UNIT-Electronics-MX/unit_devlab_i2c_mpu6050_6_axis_imu/hardware/README.md

# DevLab I2C MPU6050 6-Axis IMU Hardware

## Hardware Scope

This page documents **DevLab I2C MPU6050 6-Axis IMU** using the V1.0 schematic, board views, and available mechanical drawings. Sensor datasheet ratings are not independently validated module limits.

| Field | Value |
|---|---|
| MPN | UE0129 |

## Power Tree

The schematic identifies `U2` as an AP2112K fixed 3.3 V regulator for the MPU-6050 circuit. A separate board-level power-tree drawing is not available; use the [electrical schematic](unit_sch_v_1_0_0_ue129_mpu6050_imu.pdf) for the confirmed connections.

## Block Diagram

UE0129 functional block diagram

## Naming Rules

- Product name: **DevLab I2C MPU6050 6-Axis IMU**.
- Product family: **UNIT DevLab ecosystem**.
- Existing source files retain their published names and revisions.
- Generated Product Reference: `unit_product_reference_v_0_2_0_i2c_mpu6050_6_axis_imu.pdf`.

## Hardware

<div align="center">
<a href="./unit_sch_v_1_0_0_ue129_mpu6050_imu.pdf">V1.0 electrical schematic<br/>Schematic (PDF)</a>
</div>

UE0129 MPU6050 top view

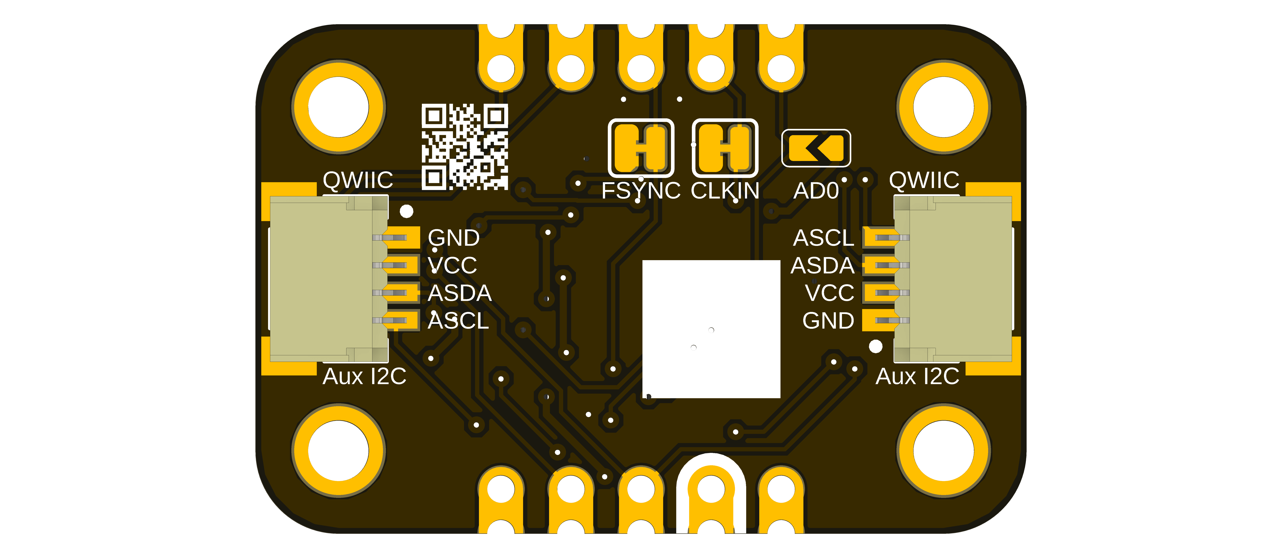
[picture p2: hardware/resources/unit_btm_v_1_1_0_ue0129_mpu6050_3d.png]
UE0129 MPU6050 bottom view


## Pinout

<div align="center">
    <a href="./unit_pinout_v_1_0_0_ue0129_mpu6050_en.pdf"><br/>Pinout</a>
    <br/>
    <br/>
    <br/>

</div>

| Connection group | Signal | Direction / type | Function |
|---|---|---|---|
| `J2` | `VCC` | Power input | Module input rail; allowed range pending validation |
| `J2` | `GND` | Power | Common ground |
| `J2` | `SCL` | I2C clock | Main host-side I2C clock |
| `J2` | `SDA` | I2C data | Main host-side I2C data |
| `J2` | `INT` | Output | MPU-6050 interrupt output |
| `J5` | `AD0` | Input | MPU-6050 I2C address-selection input |
| `J5` | `CLKIN` | Input | External clock input to the MPU-6050 |
| `J5` | `FSYNC` | Input | Frame-synchronization input |
| `J5` | `ASCL` | I2C clock | Host-side connection to the auxiliary I2C clock |
| `J5` | `ASDA` | I2C data | Host-side connection to the auxiliary I2C data |

## Dimensions

<div align="center">
<a href="./resources/unit_dimensions_v_1_0_0_ue0129_mpu6050.png"><br/> Dimensions</a>
</div>

The drawing labels a 27.94 × 18.46 mm board outline, four Ø2.2 mm mounting
holes, and 21.94 × 12.46 mm hole-center spacing. Mechanical tolerances and
physical fit remain pending validation.

## Topology

<div align="center">
<a href="./resources/unit_topology_v_1_0_0_ue0129_mpu6050.png"><br/> Topology</a>
</div>

The schematic confirms the following functional blocks:

| Ref. | Description |
|---|---|
| `IC1` | MPU-6050 three-axis accelerometer and three-axis gyroscope |
| `U2` | AP2112K-3.3 fixed 3.3 V regulator |
| `Q1`, `Q2` | BSS138AKDW dual N-channel MOSFET arrays used for I2C level shifting |
| `J1`, `J3` | Four-position main I2C connectors (`VCC`, `GND`, `SDA`, `SCL`) |
| `J4`, `J6` | Four-position auxiliary I2C connectors (`VCC`, `GND`, `ASDA`, `ASCL`) |
| `J2`, `J5` | 1x5, 2.54 mm signal headers / castellated connections |
| `D1`, `R5` | Red power indicator and 4.7 kΩ series resistor |

## Pin & Connector Layout

| Connector | Signals shown by schematic | Notes |
|---|---|---|
| `J1`, `J3` | `VCC`, `GND`, `SDA`, `SCL` | Main I2C bus; 4-position JST SR-series parts in the BOM |
| `J4`, `J6` | `VCC`, `GND`, `ASDA`, `ASCL` | Auxiliary I2C bus; 4-position JST SR-series parts in the BOM |
| `J2` | `VCC`, `GND`, `SCL`, `SDA`, `INT` | Main interface edge |
| `J5` | `AD0`, `CLKIN`, `FSYNC`, `ASCL`, `ASDA` | Configuration and auxiliary interface edge |

The board artwork labels the four JST connectors as `QWIIC`, but cable and
ecosystem compatibility have not been validated. The BOM lists one four-pin,
1 mm-pitch harness as `Wire`; package contents remain pending confirmation.

## Functional Description

`U2` generates the 3.3 V rail used by the MPU-6050. `Q1` translates the main
`SCL` and `SDA` lines between the `VCC` and 3.3 V domains; `Q2` performs the
same function for `ASCL` and `ASDA`. The MPU-6050 exposes acceleration and
angular-rate data through its main I2C interface. Its interrupt, address
selection, frame-synchronization, external-clock, and auxiliary I2C signals
are routed to board connections.

The schematic shows a 10 kΩ resistor (`R6`) from `AD0` to ground and board
artwork shows solder options for `AD0`, `FSYNC`, and `CLKIN`. The physical
defaults and intended solder-option operation are pending validation.

The BOM also confirms 1 µF regulator capacitors (`C1`, `C2`), a 2.2 nF
capacitor (`C3`), a 100 nF capacitor (`C4`), 10 nF capacitors (`C5`, `C6`),
nine 10 kΩ resistors, and the red indicator LED. Component ratings are not
module-level electrical ratings.

The MPU-6050 product specification documents selectable accelerometer ranges
of ±2 g, ±4 g, ±8 g, and ±16 g; selectable gyroscope ranges of ±250,
±500, ±1000, and ±2000 dps; and 16-bit conversion for each axis. It also
specifies a maximum 400 kHz I2C clock for the sensor. These are sensor
characteristics, not independently validated limits for the complete module.

## Applications

- Evaluation of three-axis acceleration and three-axis angular rate
- Motion-sensing prototypes
- I2C sensor integration and educational experiments
- Experiments with interrupt, synchronization, and auxiliary-sensor signals

## References

- [Repository](https://github.com/UNIT-Electronics-MX/unit_devlab_i2c_mpu6050_6_axis_imu)
- [MPU-6000 and MPU-6050 Product Specification, Revision 3.4](https://github.com/UNIT-Electronics-MX/unit_devlab_i2c_mpu6050_6_axis_imu/blob/main/hardware/resources/external/mpu-6050_datasheet_v3%204.pdf)
- [Schematic Diagram](https://github.com/UNIT-Electronics-MX/unit_devlab_i2c_mpu6050_6_axis_imu/blob/main/hardware/unit_sch_v_1_0_0_ue129_mpu6050_imu.pdf)
- [Manufacturing BOM](https://github.com/UNIT-Electronics-MX/unit_devlab_i2c_mpu6050_6_axis_imu/blob/main/hardware/resources/UNIT-0129-%20MPU6050-20260803T164655Z-1-001/UNIT-0129-%20MPU60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)
- [Experimental DevLab_MPU6050 example](https://github.com/UNIT-Electronics-MX/unit_devlab_i2c_mpu6050_6_axis_imu/blob/main/software/examples/arduino/devlab_mpu6050_basic/devlab_mpu6050_basic.ino)

The sensor datasheet values above apply to the MPU-6050 component. The
module-level electrical limits remain pending board validation.

- [Product Reference](../docs/hardware/unit_product_reference_v_0_2_0_i2c_mpu6050_6_axis_imu.pdf)
