UNIT-Electronics-MX/unit_devlab_i2c_mpu6050_6_axis_imu/tools/product-reference/chapters/06-mechanical.md

## **6 Mechanical Information**

### **6.1 Top View** {.section-page}

UE0129 MPU6050 top view.

### **6.2 Bottom View** {.section-page}

UE0129 MPU6050 bottom view.

### **6.3 Board Dimensions** {.section-page}

Released board dimensions drawing.

The released drawing labels a 27.94 × 18.46 mm board outline, four Ø2.2 mm
mounting holes, and 21.94 × 12.46 mm hole-center spacing. The drawing also
shows ten castellated edge connections. These are drawing values; mechanical
tolerances and fit remain **pending validation**. Use the labeled dimensions
rather than scaling the image.
