UNIT-Electronics-MX/unit_devlab_i2c_mpu6050_6_axis_imu/tools/product-reference/chapters/08-references.md

## **8 Reference Documentation**

| Reference | Location |
|---|---|
| Repository | [UNIT-Electronics-MX/unit_devlab_i2c_mpu6050_6_axis_imu](https://github.com/UNIT-Electronics-MX/unit_devlab_i2c_mpu6050_6_axis_imu) |
| Hardware notes | [Hardware README](https://github.com/UNIT-Electronics-MX/unit_devlab_i2c_mpu6050_6_axis_imu/blob/main/hardware/README.md) |
| Sensor datasheet | [MPU-6000 and MPU-6050 Product Specification, Revision 3.4](https://github.com/UNIT-Electronics-MX/unit_devlab_i2c_mpu6050_6_axis_imu/blob/main/hardware/resources/external/mpu-6050_datasheet_v3%204.pdf) |
| Module schematic | [V1.0 schematic](https://github.com/UNIT-Electronics-MX/unit_devlab_i2c_mpu6050_6_axis_imu/blob/main/hardware/unit_sch_v_1_0_0_ue129_mpu6050_imu.pdf) |
| Schematic image | [V1.0 schematic PNG](https://github.com/UNIT-Electronics-MX/unit_devlab_i2c_mpu6050_6_axis_imu/blob/main/hardware/resources/unit_sch_v_1_0_0_ue129_mpu6050_imu.png) |
| Pinout | [English PDF](https://github.com/UNIT-Electronics-MX/unit_devlab_i2c_mpu6050_6_axis_imu/blob/main/hardware/unit_pinout_v_1_0_0_ue0129_mpu6050_en.pdf) · [Spanish PDF](https://github.com/UNIT-Electronics-MX/unit_devlab_i2c_mpu6050_6_axis_imu/blob/main/hardware/unit_pinout_v_1_0_0_ue0129_mpu6050_es.pdf) |
| Pinout images | [English PNG](https://github.com/UNIT-Electronics-MX/unit_devlab_i2c_mpu6050_6_axis_imu/blob/main/hardware/resources/unit_pinout_v_1_0_0_ue0129_mpu6050_en.png) · [Spanish PNG](https://github.com/UNIT-Electronics-MX/unit_devlab_i2c_mpu6050_6_axis_imu/blob/main/hardware/resources/unit_pinout_v_1_0_0_ue0129_mpu6050_es.png) |
| Board topology | [Top and bottom topology drawing](https://github.com/UNIT-Electronics-MX/unit_devlab_i2c_mpu6050_6_axis_imu/blob/main/hardware/resources/unit_topology_v_1_0_0_ue0129_mpu6050.png) |
| Board dimensions | [Dimensioned drawing](https://github.com/UNIT-Electronics-MX/unit_devlab_i2c_mpu6050_6_axis_imu/blob/main/hardware/resources/unit_dimensions_v_1_0_0_ue0129_mpu6050.png) |
| Manufacturing BOM | [V1.0 BOM](https://github.com/UNIT-Electronics-MX/unit_devlab_i2c_mpu6050_6_axis_imu/blob/main/hardware/resources/UNIT-0129-%20MPU6050-20260803T164655Z-1-001/UNIT-0129-%20MPU60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) |
| Experimental firmware | [DevLab_MPU6050 basic readout](https://github.com/UNIT-Electronics-MX/unit_devlab_i2c_mpu6050_6_axis_imu/blob/main/software/examples/arduino/devlab_mpu6050_basic/devlab_mpu6050_basic.ino) |
| Top view | [3D board view](https://github.com/UNIT-Electronics-MX/unit_devlab_i2c_mpu6050_6_axis_imu/blob/main/hardware/resources/unit_top_v_1_0_0_ue0129_mpu6050_3d.png) |
| Bottom view | [3D board view](https://github.com/UNIT-Electronics-MX/unit_devlab_i2c_mpu6050_6_axis_imu/blob/main/hardware/resources/unit_btm_v_1_1_0_ue0129_mpu6050_3d.png) |
| CAD model | [STEP](https://github.com/UNIT-Electronics-MX/unit_devlab_i2c_mpu6050_6_axis_imu/blob/main/hardware/mechanics/unit_3d_v_1_0_0_ue0129_mpu6050.step) |

Sensor values in this reference are taken from the MPU-6050 portions of the
Revision 3.4 product specification. Module-level limits require separate board
validation.
