UNIT-Electronics-MX/unit_devlab_i2c_mpu6050_6_axis_imu/tools/product-reference/chapters/01-board.md

## **1 The Module**

### **1.1 Board Identification**

| Item | Value |
|---|---|
| Product | DevLab: I2C MPU-6050 6-Axis IMU Module |
| Manufacturer part number | UE0129 |
| Hardware revision | V1.0 |
| Inertial sensor | MPU-6050 |
| Host interface | I2C |
| Product-reference revision | 0.2.0 |

### **1.2 Package Contents**

The BOM includes one four-pin, 1 mm-pitch harness. Package contents and cable
compatibility have not been formally validated; confirm them with the
distributor before purchase or integration.
