UNIT-Electronics-MX/unit_devlab_i2c_mpu6050_6_axis_imu/tools/product-reference/chapters/09-appendix.md

## **9 Appendix**

### **9.1 Source Hierarchy**

This product reference uses the MPU-6000 and MPU-6050 Product Specification,
Revision 3.4 for sensor characteristics, the released schematic for circuit
connectivity, the manufacturing BOM for fitted component identities and
values, and the released pinout, topology, board views, and dimensioned
drawing for visible labels and physical features. A future approved
validation report takes precedence if it conflicts with this edition.

### **9.2 Items Pending Validation**

- Module `VCC` operating and absolute-maximum ratings
- Module current consumption and host-side logic levels
- Module-level I2C clock testing, board-default address, and configuration sequences
- Mechanical tolerances and physical fit against the dimensioned drawing
- Solder-option defaults and connector orientation
- Cable and ecosystem compatibility
- Validated firmware examples and measurement results

### **9.3 Document Control**

| Field | Value |
|---|---|
| Product | DevLab: I2C MPU-6050 6-Axis IMU Module |
| Manufacturer part number | UE0129 |
| Hardware revision | V1.0 |
| Product-reference revision | 0.2.0 |
| Publication date | 2026-10-21 |
| Firmware status | Experimental; not validated by this edition |
