UNIT-Electronics-MX/unit_devlab_i2c_mpu6050_6_axis_imu/docs/hardware/index.html

UNIT Electronics · DevLab

# DevLab I2C MPU-6050 6-Axis IMU Module

Direct links to hardware documentation and product files for use in external platforms.

24 files 14 images 9 formats 63.2 MB total

Search hardware resources

## Product documents

4 files

DOCX 7.6 MB

### Product Reference

Editable product reference

unit_product_reference_v_0_2_0_i2c_mpu6050_6_axis_imu.docx

Copy link Open file

PDF 8.6 MB

### Product Reference

Publication-ready product reference

unit_product_reference_v_0_2_0_i2c_mpu6050_6_axis_imu.pdf

Copy link Open file

PDF 53.9 KB

### Schematic

Electrical schematic

unit_sch_v_1_0_0_ue129_mpu6050_imu.pdf

Copy link Open file

PNG 480.8 KB

### Schematic

Electrical schematic

resources/unit_sch_v_1_0_0_ue129_mpu6050_imu.png

Copy link Open file

## Pinouts

6 files

JPG 9.2 MB

### Pinout — English

Connector and signal reference in English

resources/unit_pinout_v_1_0_0_ue0129_mpu6050_en.jpg

Copy link Open file

PDF 6.5 MB

### Pinout — English

Connector and signal reference in English

unit_pinout_v_1_0_0_ue0129_mpu6050_en.pdf

Copy link Open file

PNG 2.8 MB

### Pinout — English

Connector and signal reference in English

resources/unit_pinout_v_1_0_0_ue0129_mpu6050_en.png

Copy link Open file

JPG 9.2 MB

### Pinout — Spanish

Connector and signal reference in Spanish

resources/unit_pinout_v_1_0_0_ue0129_mpu6050_es.jpg

Copy link Open file

PDF 6.5 MB

### Pinout — Spanish

Connector and signal reference in Spanish

unit_pinout_v_1_0_0_ue0129_mpu6050_es.pdf

Copy link Open file

PNG 2.8 MB

### Pinout — Spanish

Connector and signal reference in Spanish

resources/unit_pinout_v_1_0_0_ue0129_mpu6050_es.png

Copy link Open file

## Board views

4 files

PNG 1.1 MB

### Board Topology

Functional board layout

resources/unit_topology_v_1_0_0_ue0129_mpu6050.png

Copy link Open file

PNG 1.3 MB

### Bottom View

Bottom-side board view

resources/unit_btm_v_1_1_0_ue0129_mpu6050_3d.png

Copy link Open file

PNG 908.6 KB

### Mechanical Dimensions

Board outline and dimensions

resources/unit_dimensions_v_1_0_0_ue0129_mpu6050.png

Copy link Open file

PNG 1.4 MB

### Top View

Top-side board view

resources/unit_top_v_1_0_0_ue0129_mpu6050_3d.png

Copy link Open file

## CAD and design files

1 file

STEP 1.2 MB

### 3D CAD Model

STEP mechanical model

mechanics/unit_3d_v_1_0_0_ue0129_mpu6050.step

Copy link Open file

## Other resources

9 files

FILE 41 B

### .Gitattributes

Hardware resource

mechanics/.gitattributes

Copy link Open file

PNG 28.2 KB

### Arduinolibrary

Hardware resource

resources/img/arduinolibrary.png

Copy link Open file

PNG 52.5 KB

### Cdcesp32

Hardware resource

resources/img/cdcesp32.png

Copy link Open file

PNG 511.0 KB

### Connmpu6050

Hardware resource

resources/img/connmpu6050.png

Copy link Open file

MD 6.7 KB

### Hardware README

Hardware overview and source notes

README.md

Copy link Open file

PDF 1.4 MB

### Mpu 6050 Datasheet V3 4

Hardware resource

resources/external/mpu-6050_datasheet_v3 4.pdf

Copy link Open file

F3D 1.3 MB

### Unit 3D V 1 0 0 Ue0129 Mpu6050

Hardware resource

mechanics/unit_3d_v_1_0_0_ue0129_mpu6050.f3d

Copy link Open file

PNG 72.2 KB

### Unit Block Diagram V 1 0 0 Ue0129 Mpu6050

Hardware resource

resources/unit_block_diagram_v_1_0_0_ue0129_mpu6050.png

Copy link Open file

SVG 5.5 KB

### Unit Block Diagram V 1 0 0 Ue0129 Mpu6050

Hardware resource

resources/unit_block_diagram_v_1_0_0_ue0129_mpu6050.svg

Copy link Open file

No resources match your search.

UNIT Electronics hardware resources
