UNIT-Electronics-MX/unit_devlab_i2c_mpu6050_6_axis_imu/docs/hardware/resources/unit_pinout_v_1_0_0_ue0129_mpu6050_es.png

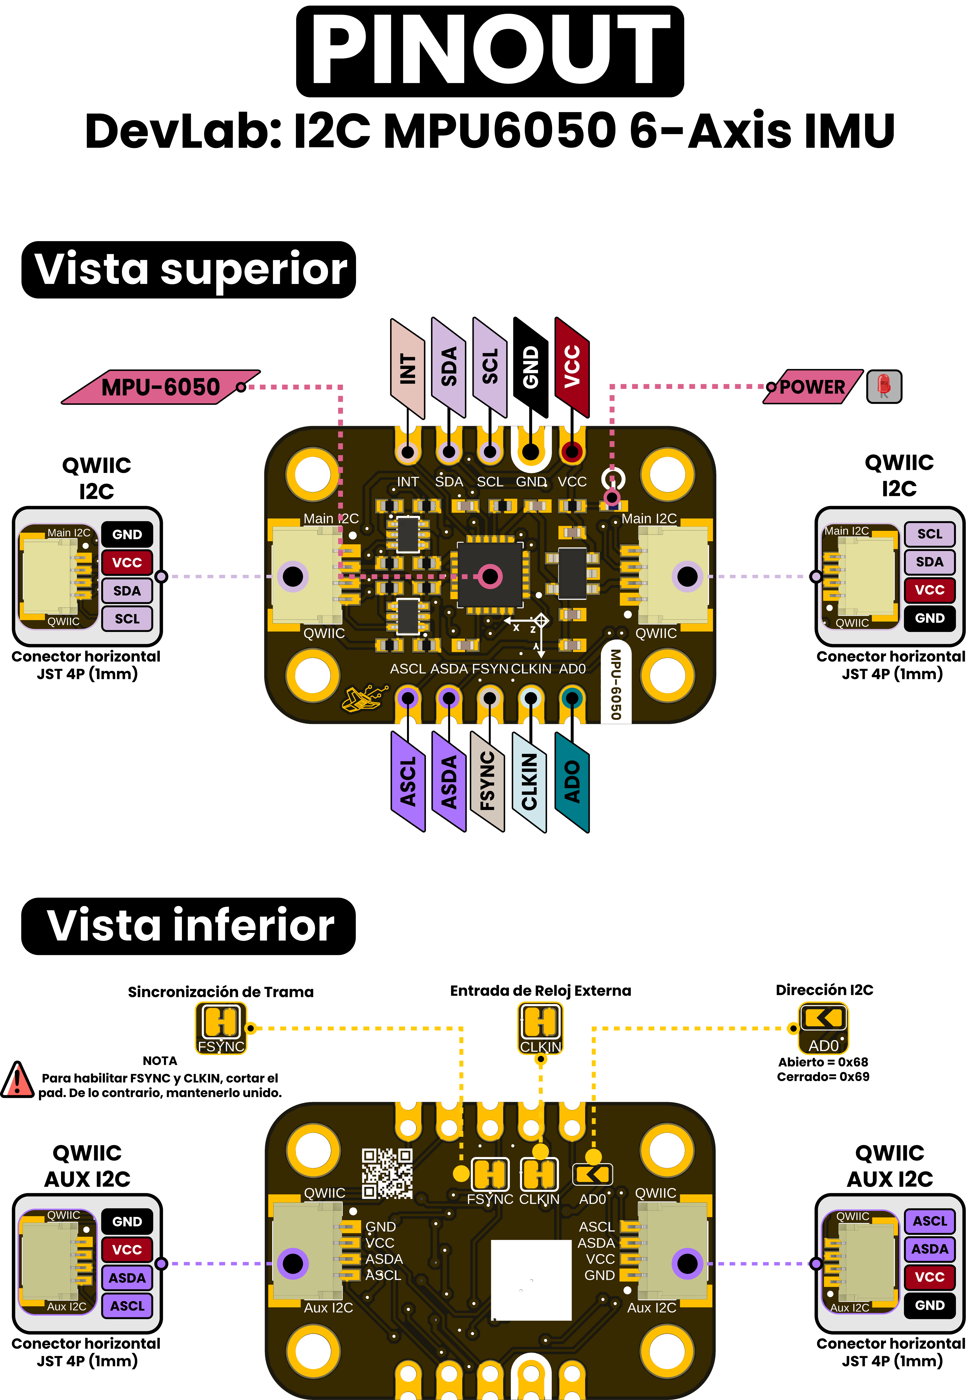
docs/hardware/resources/unit_pinout_v_1_0_0_ue0129_mpu6050_es.png
