UNIT-Electronics-MX/unit_devlab_i2c_mpu6050_6_axis_imu/hardware/mechanics/unit_3d_v_1_0_0_ue0129_mpu6050.step

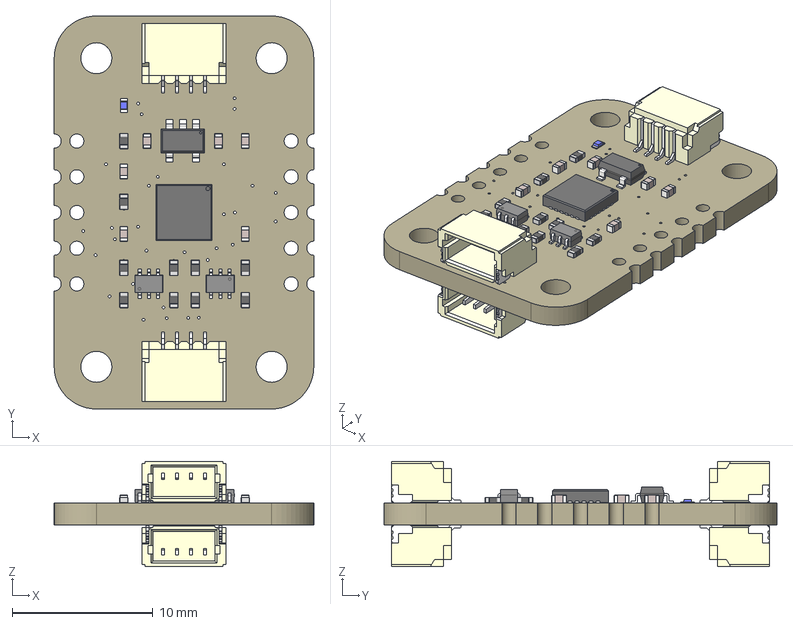
[picture p11: CAD file, 2026-11-02]
hardware/mechanics/unit_3d_v_1_0_0_ue0129_mpu6050.step
18.5 x 27.9 x 7.49 mm
Placa
M2-THICK-OUTLINE x 4
CASTELLATED_1X5_2.54MM
CASTELLATED_1X5_2.54MM_1
SM04B-SRSS-TB(LF)(SN)--3DModel-STEP-56544 v1 x 4
0402_R x 10
