UNIT-Electronics-MX/unit_devlab_i2c_mpu6050_6_axis_imu/(list of files, cad)

Other CAD files:
docs/hardware/mechanics/unit_3d_v_1_0_0_ue0129_mpu6050.f3d
