UNIT-Electronics-MX/unit_devlab_i2c_mpu6050_6_axis_imu/hardware/unit_pinout_v_1_0_0_ue0129_mpu6050_en.pdf

# PINOUT

# DevLab: I2C MPU6050 6-Axis IMU

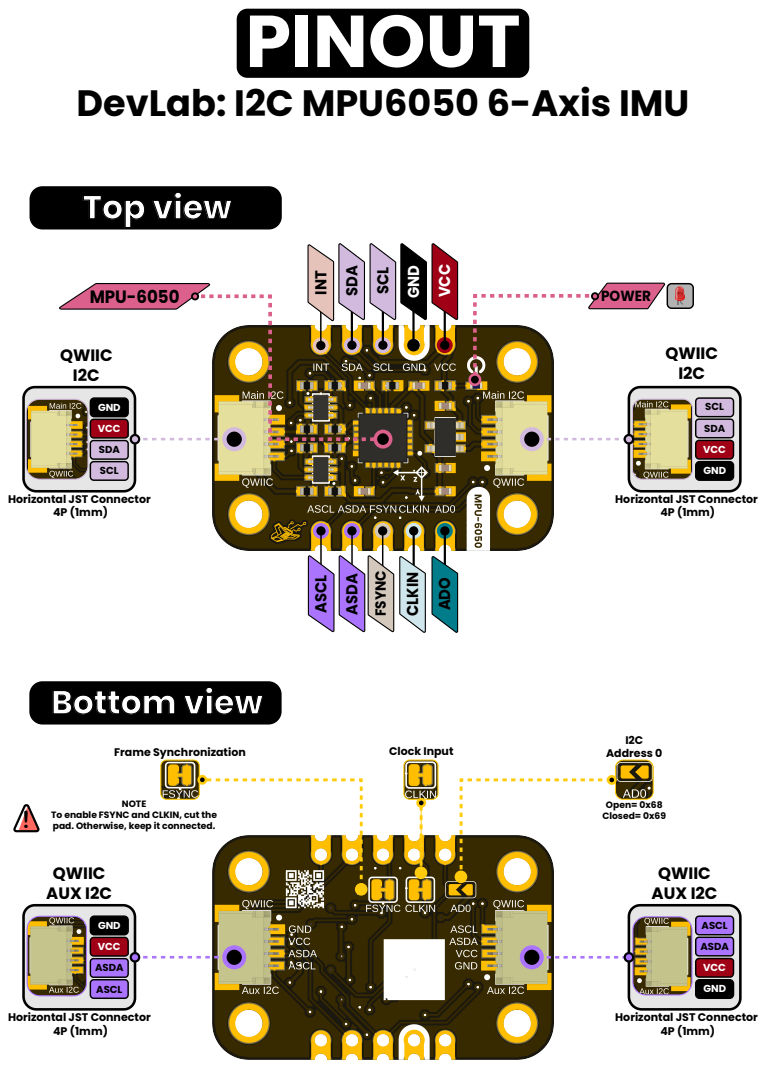
[picture p12: page 1]
Bottom view; Top view; VCC SDA SCL; GND; Frame Synchronization; QWIIC I2C; VCC; SDA; SCL; QWIIC AUX I2C; FSYNC; POWER; ASDA; INT ASCL; CLKIN; ADO; MPU-6050; VCC ASDA ASCL; ASCL; NOTE; Open= 0x68 Closed= 0x69; Clock Input; Address 0

Horizontal JST Connector

To enable FSYNC and CLKIN, cut the
pad. Otherwise, keep it connected.
QWIIC
AUX I2C
