UNIT-Electronics-MX/unit_devlab_i2c_mpu6050_6_axis_imu/hardware/unit_pinout_v_1_0_0_ue0129_mpu6050_es.pdf

# PINOUT

# DevLab: I2C MPU6050 6-Axis IMU

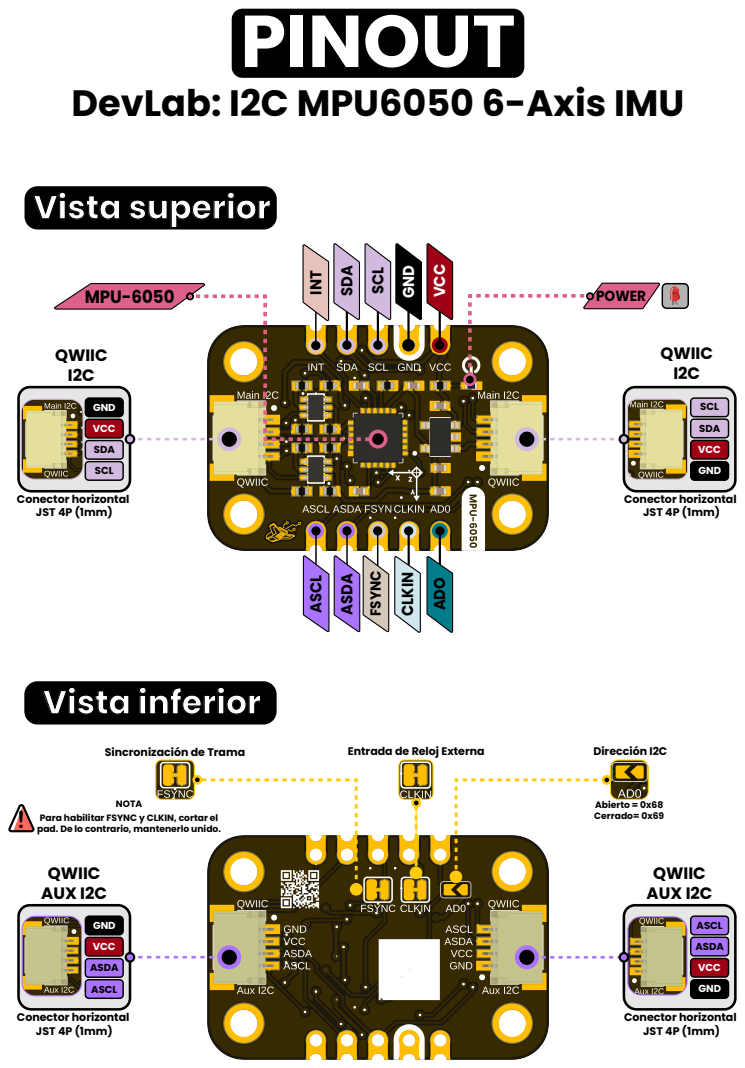
[picture p13: page 1]
Vista inferior; Vista superior; Conector horizontal JST 4P (1mm); VCC SDA SCL; GND; QWIIC I2C; VCC; SDA; SCL; QWIIC AUX I2C; FSYNC; POWER; ASDA; INT ASCL; CLKIN; ADO; MPU-6050; VCC ASDA ASCL; ASCL; NOTA; Abierto = 0x68 Cerrado= 0x69; Entrada de Reloj Externa; Dirección I2C

Sincronización de Trama

Para habilitar FSYNC y CLKIN, cortar el
pad. De lo contrario, mantenerlo unido.
QWIIC
AUX I2C
