UNIT-Electronics-MX/unit_devlab_i2c_mpu6050_6_axis_imu/docs/hardware/unit_sch_v_1_0_0_ue129_mpu6050_imu.pdf

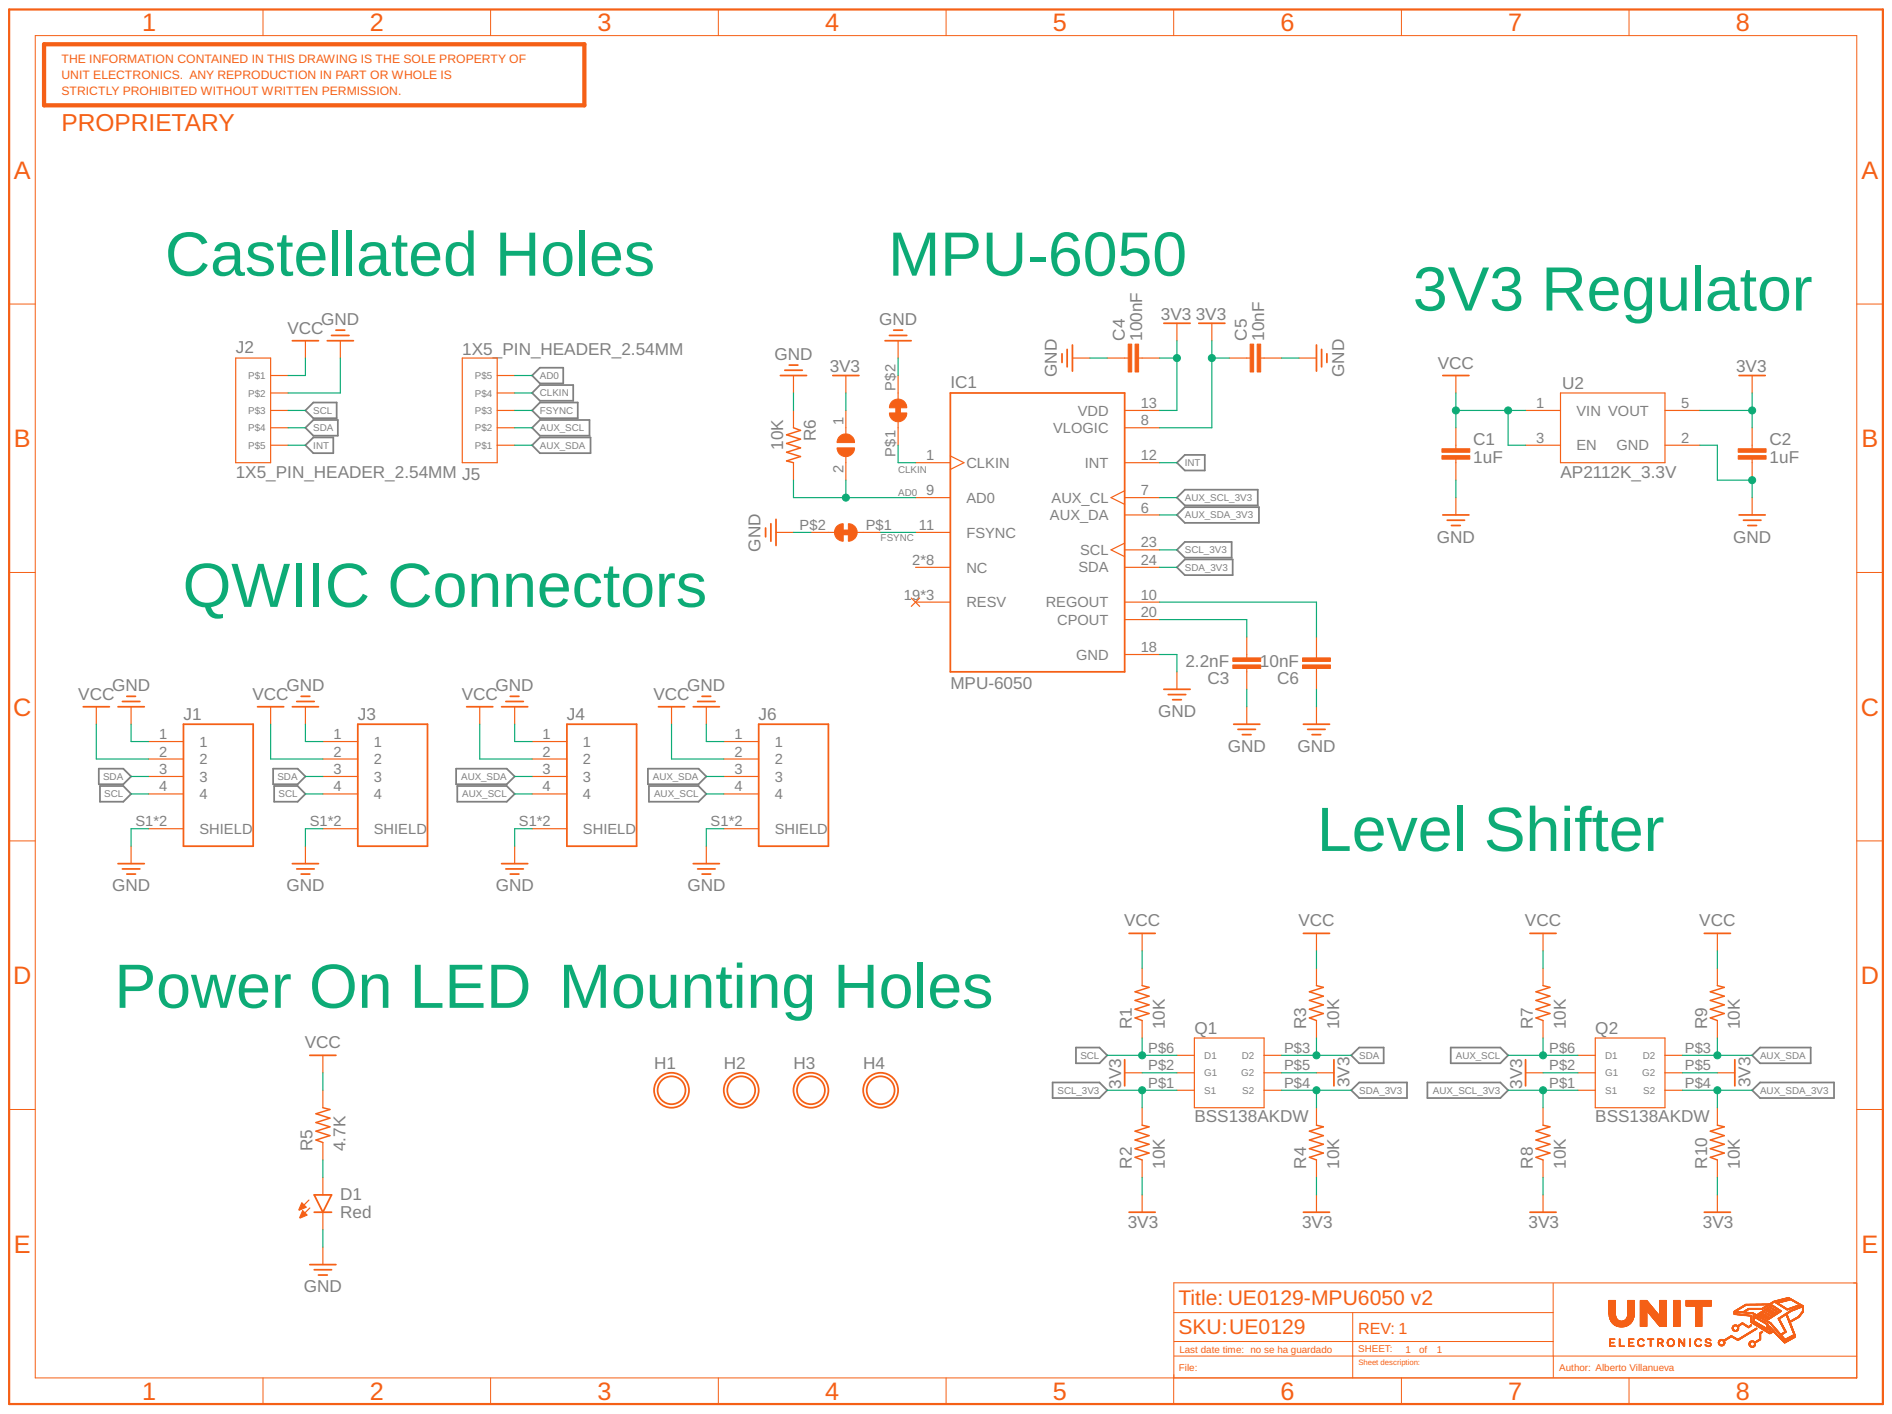
[picture p14: page 1]

THE INFORMATION CONTAINED IN THIS DRAWING IS THE SOLE PROPERTY OF UNIT ELECTRONICS. ANY REPRODUCTION IN PART OR WHOLE IS

STRICTLY PROHIBITED WITHOUT WRITTEN PERMISSION. PROPRIETARY
