UNIT-Electronics-MX/unit_devlab_i2c_mpu6050_6_axis_imu/(commit log)

2026-05-15 docs: upload schematic file
2026-08-03 feat: add Arduino examples for MPU6050
2026-10-21 docs: update product reference with pinout and schematic
2026-10-27 docs: update functional overview for the sensor
2026-10-27 docs: update board operation
2026-10-27 docs: update board operation infor
2026-11-02 Integrate product-specific board views and mechanical assets
